helenaw041/ELEC-240-PCBs/No MCU Sequencer/docs/Top 3D Viewer.png

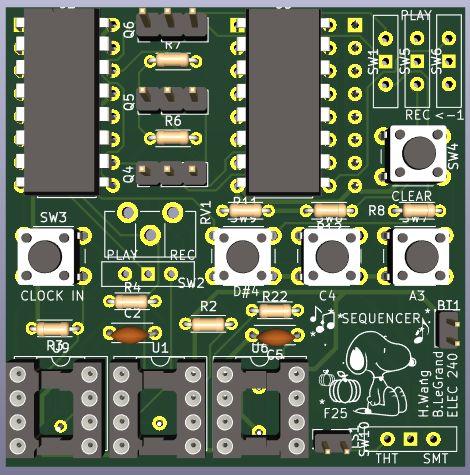
No MCU Sequencer/docs/Top 3D Viewer.png
