helenaw041/ELEC-240-PCBs/README.md

# ELEC-240-PCBs
Make any PCB related to Halloween or Christmas with at least 1 IC!
