helenaw041/ELEC-240-PCBs/No MCU Sequencer/docs/Bottom 3D Viewer.png

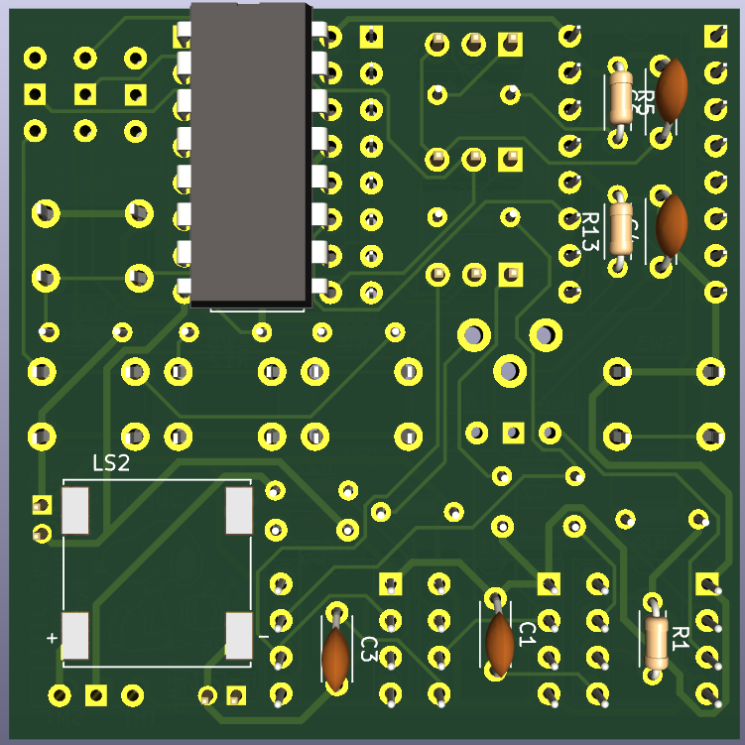
No MCU Sequencer/docs/Bottom 3D Viewer.png
