helenaw041/ELEC-240-PCBs/No MCU Sequencer/docs/Bottom Silkscreen.png

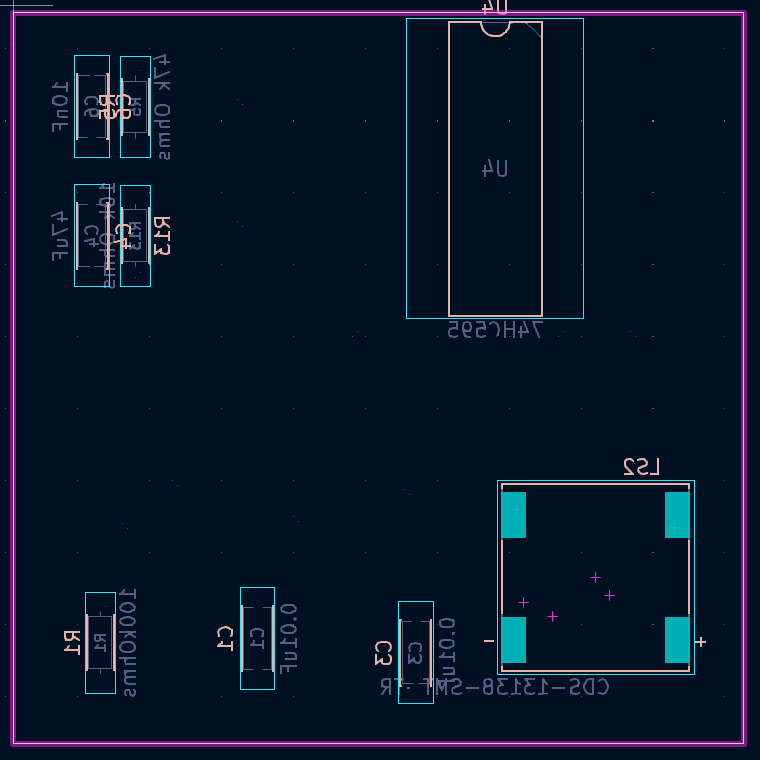
No MCU Sequencer/docs/Bottom Silkscreen.png
