helenaw041/ELEC-240-PCBs/No MCU Sequencer/docs/Top Silkscreen.png

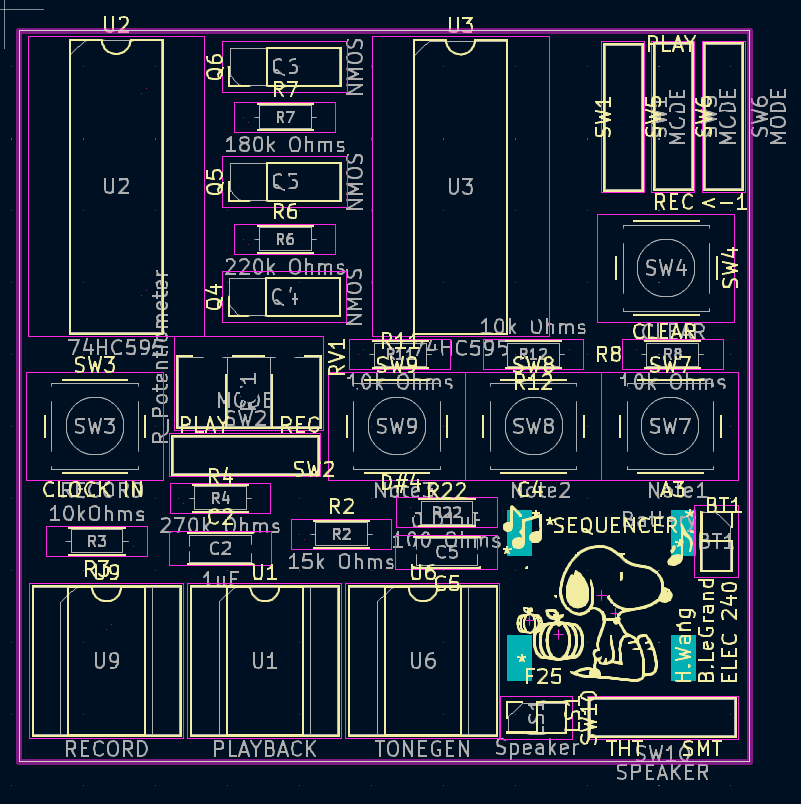
No MCU Sequencer/docs/Top Silkscreen.png
