helenaw041/ELEC-240-PCBs/No MCU Sequencer/docs/Schematic.pdf

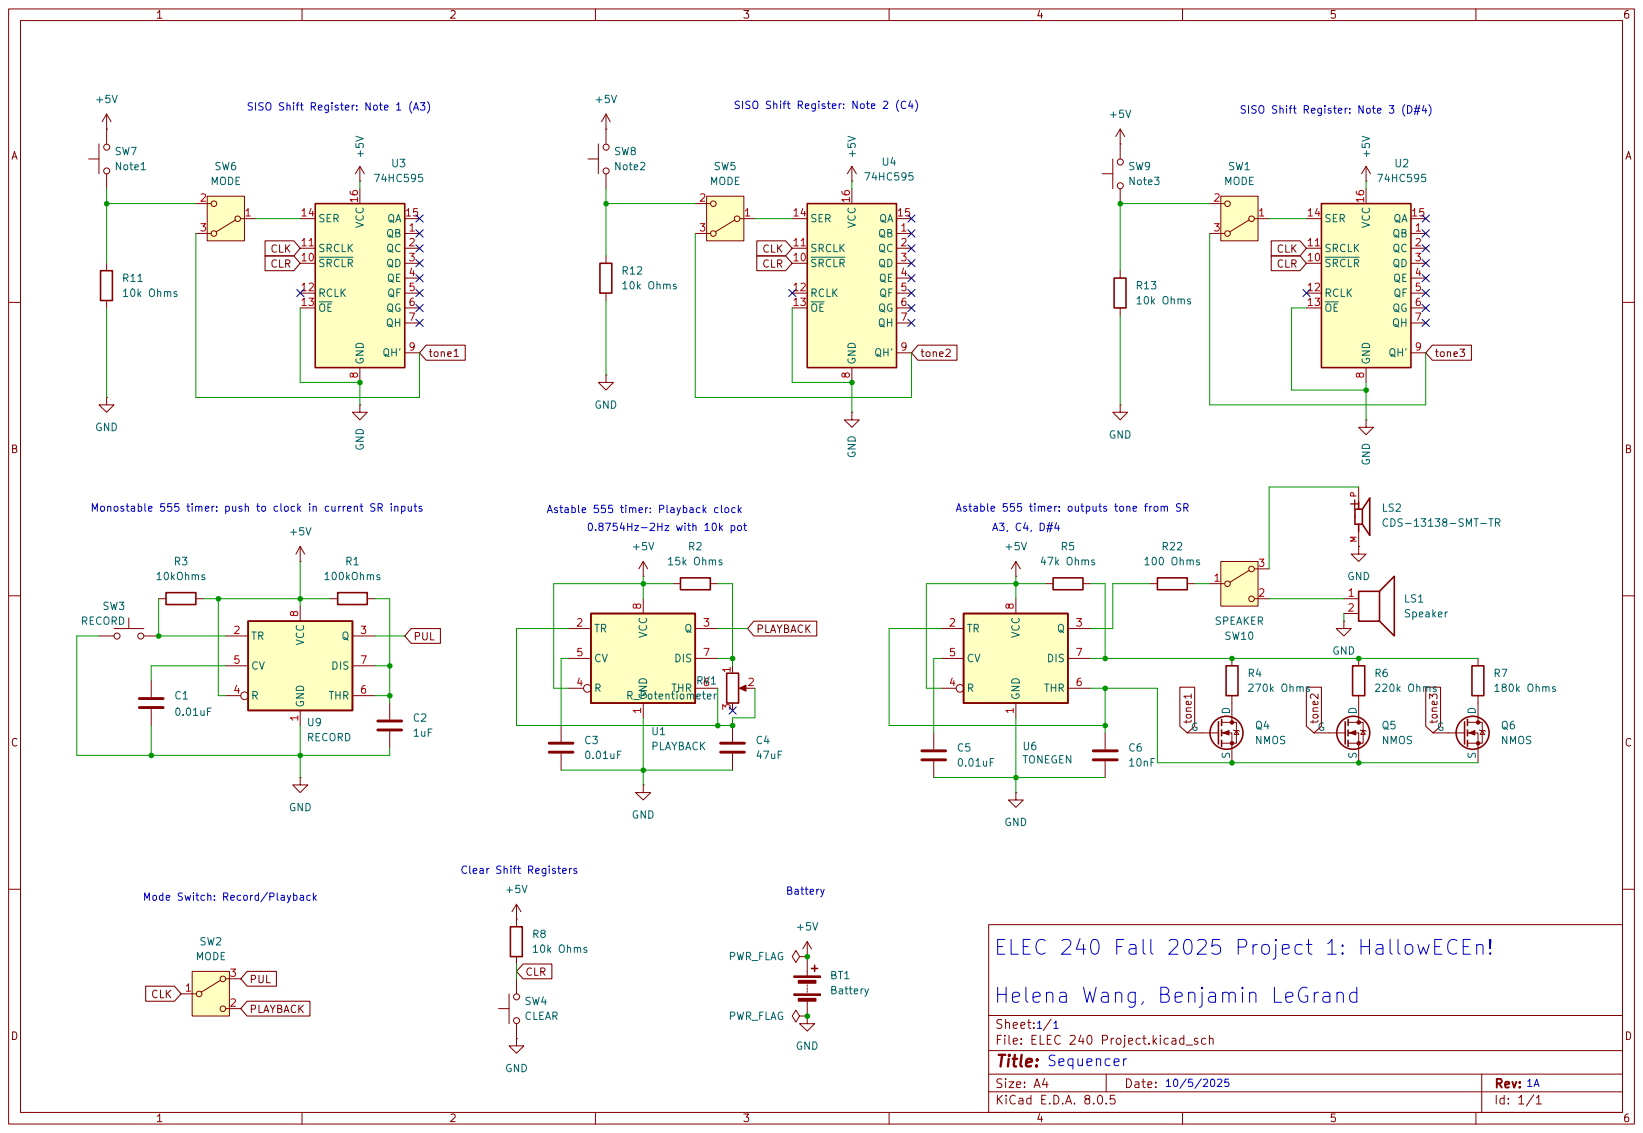
[picture p5: page 1]
