helenaw041/ELEC-240-PCBs/No MCU Sequencer/ELEC 240 Project.kicad_pcb

## KiCad design No MCU Sequencer/ELEC 240 Project.kicad_pcb (2025-10-13)

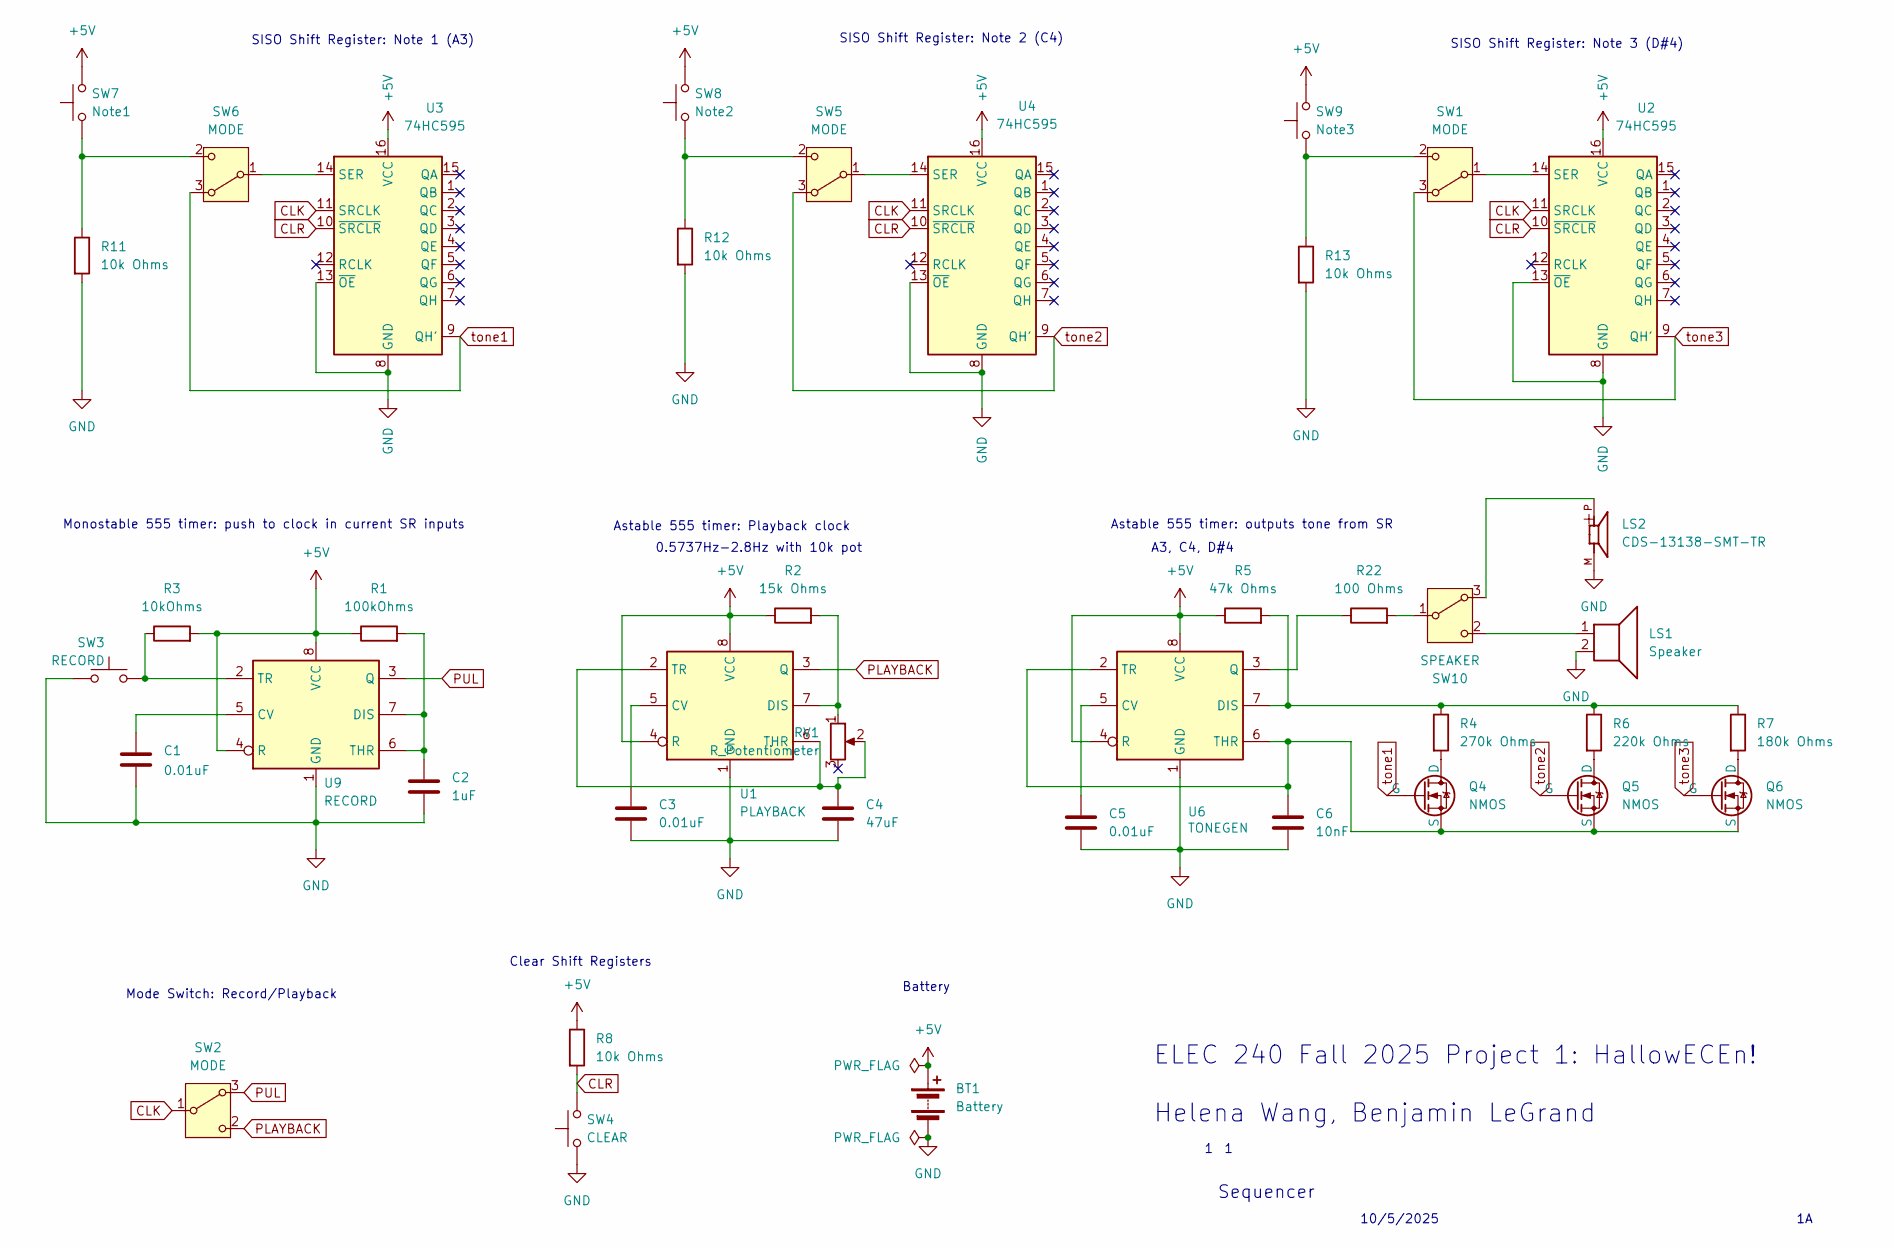
[picture p6: schematic ELEC 240 Project.kicad_sch]

Parts:
BT1: Battery; PinHeader_2x01_P2.00mm_Vertical
C1, C3, C5: 0.01uF; C_Disc_D4.3mm_W1.9mm_P5.00mm
C2: 1uF; C_Disc_D4.3mm_W1.9mm_P5.00mm
C4: 47uF; C_Disc_D4.3mm_W1.9mm_P5.00mm
C6: 10nF; C_Disc_D4.3mm_W1.9mm_P5.00mm
LS1: Speaker; PinHeader_2x01_P2.00mm_Vertical
LS2: CDS-13138-SMT-TR; SPKR_CDS-13138-SMT-TR
Q4, Q5, Q6: NMOS; PinHeader_1x03_P2.54mm_Vertical
R1: 100kOhms; R_Axial_DIN0204_L3.6mm_D1.6mm_P5.08mm_Horizontal
R2: 15k Ohms; R_Axial_DIN0204_L3.6mm_D1.6mm_P5.08mm_Horizontal
R3: 10kOhms; R_Axial_DIN0204_L3.6mm_D1.6mm_P5.08mm_Horizontal
R4: 270k Ohms; R_Axial_DIN0204_L3.6mm_D1.6mm_P5.08mm_Horizontal
R5: 47k Ohms; R_Axial_DIN0204_L3.6mm_D1.6mm_P5.08mm_Horizontal
R6: 220k Ohms; R_Axial_DIN0204_L3.6mm_D1.6mm_P5.08mm_Horizontal
R7: 180k Ohms; R_Axial_DIN0204_L3.6mm_D1.6mm_P5.08mm_Horizontal
R8, R11, R12, R13: 10k Ohms; R_Axial_DIN0204_L3.6mm_D1.6mm_P5.08mm_Horizontal
R22: 100 Ohms; R_Axial_DIN0204_L3.6mm_D1.6mm_P5.08mm_Horizontal
RV1: R_Potentiometer; Potentiometer_ACP_CA9-H2,5_Horizontal
SW1, SW2, SW5, SW6: MODE; SW_Slide-03_Wuerth-WS-SLTV_10x2.5x6.4_P2.54mm
SW3: RECORD; SW_PUSH_6mm
SW4: CLEAR; SW_PUSH_6mm
SW7: Note1; SW_PUSH_6mm
SW8: Note2; SW_PUSH_6mm
SW9: Note3; SW_PUSH_6mm
SW10: SPEAKER; SW_Slide-03_Wuerth-WS-SLTV_10x2.5x6.4_P2.54mm
U1: PLAYBACK; DIP-8_W7.62mm_Socket
U2, U3, U4: 74HC595; DIP-16_W10.16mm
U6: TONEGEN; DIP-8_W7.62mm_Socket
U9: RECORD; DIP-8_W7.62mm_Socket

Connections:
+5V: BT1.1 (+), R1.1, R2.1, R3.2, R5.1, R8.1, SW7.2, SW8.2, SW9.2, U1.4 (R), U1.8 (VCC), U2.16 (VCC), U3.16 (VCC), U4.16 (VCC), U6.4 (R), U6.8 (VCC), U9.4 (R), U9.8 (VCC)
CLK: SW2.1 (B), U2.11 (SRCLK), U3.11 (SRCLK), U4.11 (SRCLK)
CLR: R8.2, SW4.2, U2.10 (~SRCLR), U3.10 (~SRCLR), U4.10 (~SRCLR)
GND: BT1.2 (-), C1.1, C2.2, C3.2, C4.2, C5.2, C6.2, LS1.2, LS2.M, R11.2, R12.2, R13.2, SW3.1, SW4.1, U1.1 (GND), U2.8 (GND), U2.13 (~OE), U3.8 (GND), U3.13 (~OE), U4.8 (GND), U4.13 (~OE), U6.1 (GND), U9.1 (GND)
unnamed: Q4.1 (D), R4.2
unnamed: C6.1, Q4.3 (S), Q5.3 (S), Q6.3 (S), U6.2 (TR), U6.6 (THR)
unnamed: Q5.1 (D), R6.2
unnamed: Q6.1 (D), R7.2
unnamed: SW1.1 (B), U2.14 (SER)
unnamed: R13.1, SW1.2 (C), SW9.1
unnamed: SW5.1 (B), U4.14 (SER)
unnamed: R12.1, SW5.2 (C), SW8.1
unnamed: SW6.1 (B), U3.14 (SER)
unnamed: R11.1, SW6.2 (C), SW7.1
unnamed: LS2.P, SW10.3 (A)
unnamed: R22.2, SW10.1 (B)
unnamed: LS1.1, SW10.2 (C)
unnamed: C3.1, U1.5 (CV)
unnamed: R2.2, RV1.1, U1.7 (DIS)
unnamed: C4.1, RV1.2, U1.2 (TR), U1.6 (THR)
unnamed: C5.1, U6.5 (CV)
unnamed: R4.1, R5.2, R6.1, R7.1, U6.7 (DIS)
unnamed: R22.1, U6.3 (Q)
unnamed: C1.2, U9.5 (CV)
unnamed: C2.1, R1.2, U9.6 (THR), U9.7 (DIS)
unnamed: R3.1, SW3.2, U9.2 (TR)
PLAYBACK: SW2.2 (C), U1.3 (Q)
PUL: SW2.3 (A), U9.3 (Q)
tone1: Q4.2 (G), SW6.3 (A), U3.9 (QH')
tone2: Q5.2 (G), SW5.3 (A), U4.9 (QH')
tone3: Q6.2 (G), SW1.3 (A), U2.9 (QH')

Notes on the sheet:
A3, C4, D#4
Mode Switch: Record/Playback
Monostable 555 timer: push to clock in current SR inputs
Battery
ELEC 240 Fall 2025 Project 1: HallowECEn! Helena Wang, Benjamin LeGrand
Astable 555 timer: Playback clock
0.5737Hz-2.8Hz with 10k pot
Astable 555 timer: outputs tone from SR
Sequencer
SISO Shift Register: Note 2 (C4)
SISO Shift Register: Note 1 (A3)
10/5/2025
Clear Shift Registers
SISO Shift Register: Note 3 (D#4)

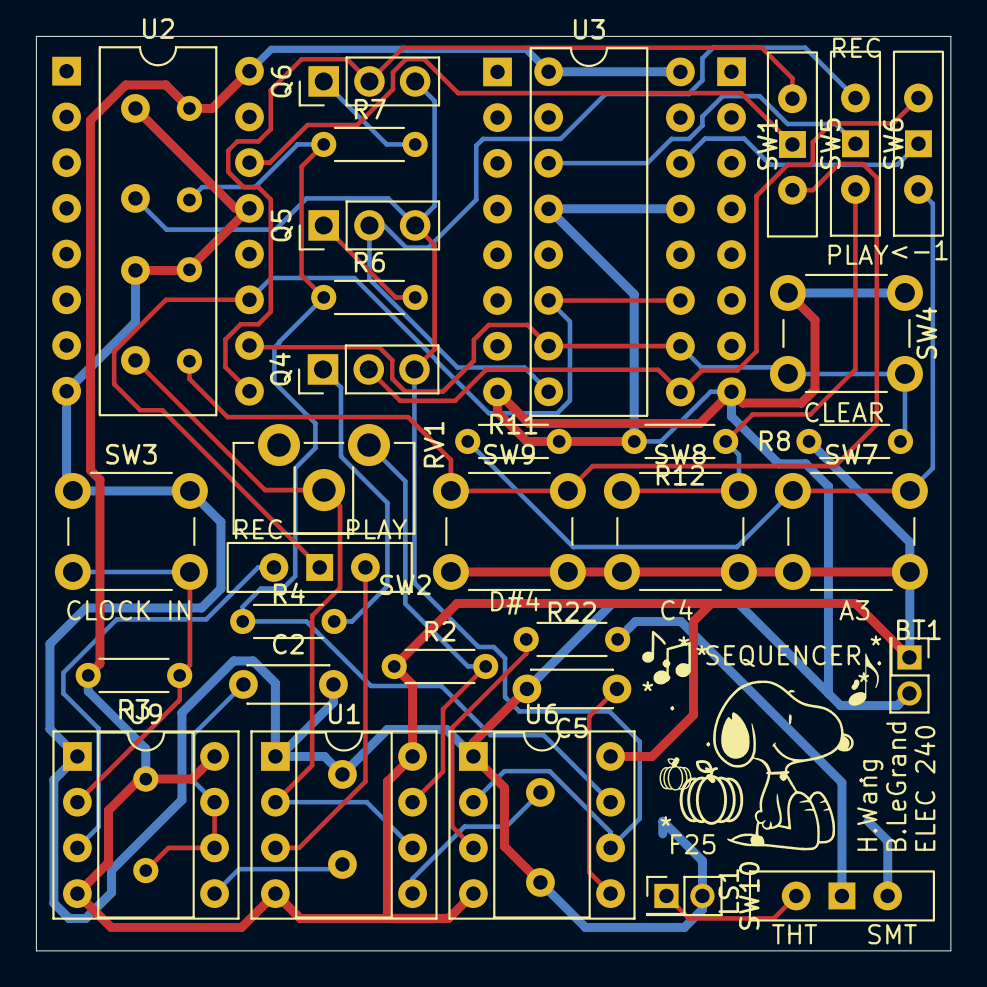
[picture p7: board ELEC 240 Project.kicad_pcb from above]

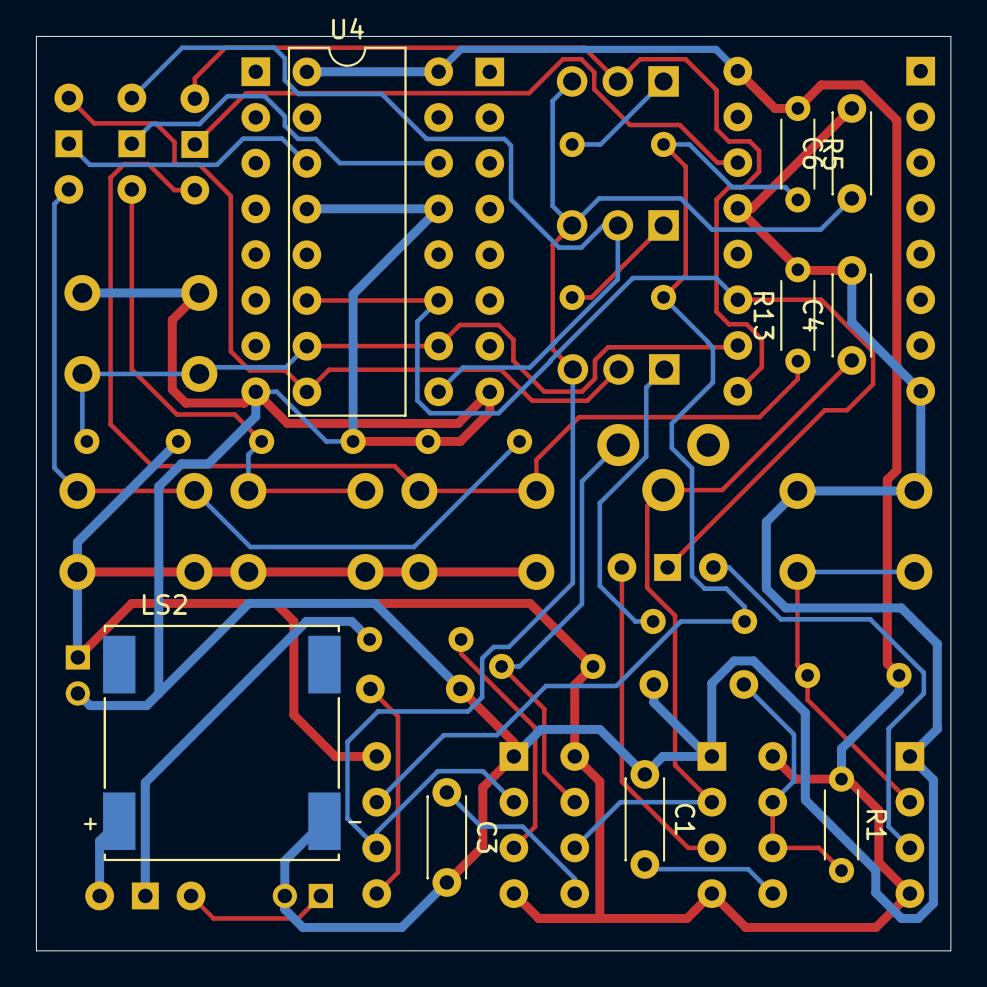
[picture p8: board ELEC 240 Project.kicad_pcb from below]

Board: 2 copper layers, 50.8 x 50.8 mm, 46 parts (9 on the bottom side), 31 nets.

Other parts of the board:
': LOGO
,: LOGO
.: LOGO
:: LOGO
`: LOGO
